mdevhurt1/enpm701-block-retrieval-robot/BOM.xlsx

ENPM809T: Autonomous Robotics
Vendor | Item | Qty | Description / Notes
Adafruit | Raspberry Pi 3 - Model B+ or Model 4 | 1
 | Raspberry Pi Camera Board v2 - 8 Megapixels | 1
 | 16GB Card with NOOBS 3.1 for Raspberry Pi Computers including 4 | 1
 | Half-sized breadboard | 2
 | Ultrasonic distance sensor | 1
 | 5V 2.5A Switching Power Supply with 20AWG MicroUSB Cable | 1
 | 9-DOF Absolute Orientation IMU Fusion Breakout - BNO055 | 1
 | Micro B USB to USB C Adapter | 1
 | USB cable - USB A to Micro-B 3 foot long | 1
RobotShop | 4WD Arduino compatible robot platform w/ encoders | 1
Amazon | Omars Battery Pack Power Bank 10000mAh USB C Battery Bank | 1
 | Pack of 12 inch 40 pin male to female dupont wire, etc. | 1
 | L298N motor drive controller board module, dual H-bridge | 1
 | Rechargable battery charger | 1
 | Rechargable batteries | 1
 | Sterilite 17631706 27 Quart/26 Liter ClearView Latch Box, Clear with Sweet Plum Latches, 6-Pack | 1
 | Hitec 31311S HS-311 Servo Standard Universal | 1
 | Arduino Nano | 1
 | GANA Micro HDMI to HDMI Adapter Cable, Micro HDMI to HDMI Cable (Male to Female) (*Only need 1 per kit) | 0.5
 | Antrader 1-Feet Mini USB 2.0 Cable A-Male to Mini-B 30cm Length 12pcs/lot (*Only need 1 per kit) | 0.08
 | Hilitchi 120pcs M2 Male Female Nylon Hex Spacer | 1
 | Steel machine screw hex nut, #4-40 (*Only need 4 per kit) | 0.04
 | #4-40 x 1/2" stainless pan head phillips machine screw (*Only need 4 per kit) | 0.04
 | Standoff, male to female, 3/16" OD hex, 4-40 x 1" L (*Only need 2 per kit) | 0.2
 | 1000 Ohm resistors | 5
Servo City | Parallel Gripper Kit A | 1
