mdevhurt1/enpm701-block-retrieval-robot/CAD/HBridgeMount.stl

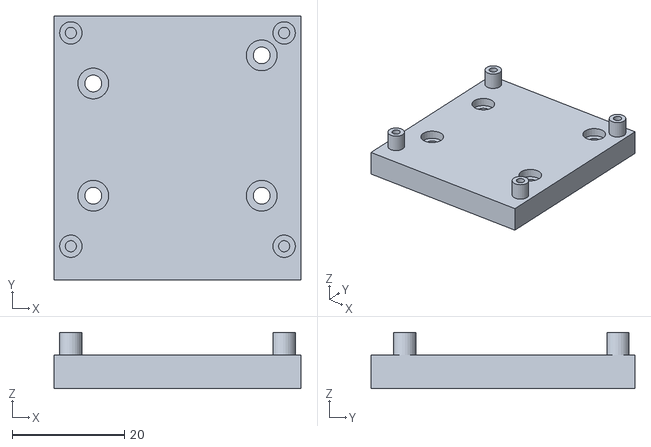
[picture p3: CAD file, 2026-04-25]
CAD/HBridgeMount.stl
44.0 x 47.0 x 10.0
