mdevhurt1/enpm701-block-retrieval-robot/CAD/FlapHolder.stl

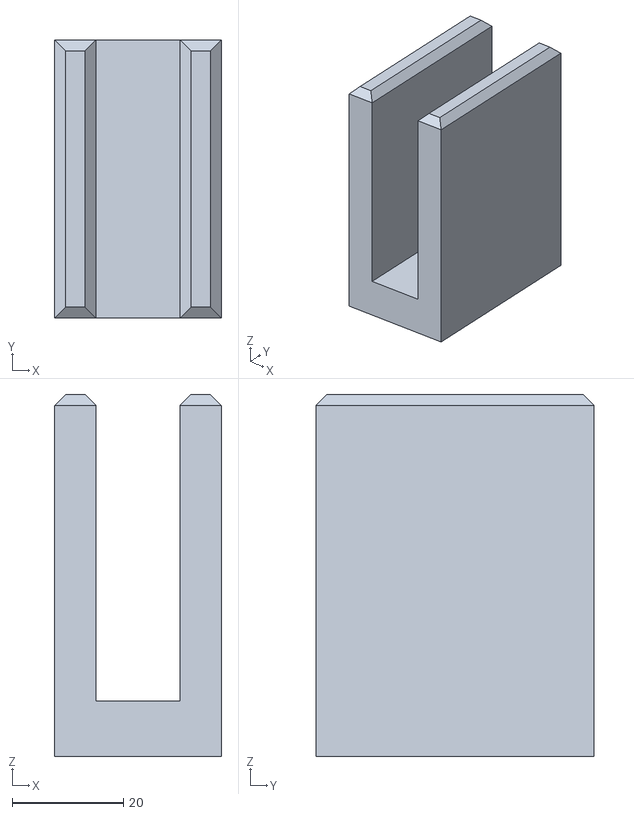
[picture p4: CAD file, 2026-04-25]
CAD/FlapHolder.stl
30.0 x 50.0 x 65.0
