mdevhurt1/enpm701-block-retrieval-robot/ENPM701-Baron-01.step

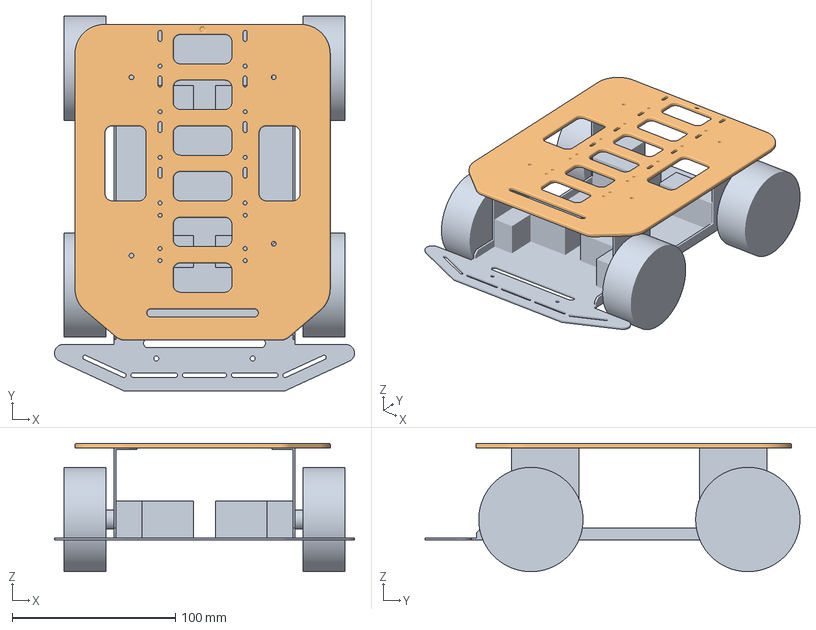
[picture p5: CAD file, 2026-04-25]
ENPM701-Baron-01.step
184.1 x 230.0 x 78.7 mm
ENPM701-Baron-01
ENPM701-Baron-02
