mdevhurt1/enpm701-block-retrieval-robot/CAD/BatteryCage.stl

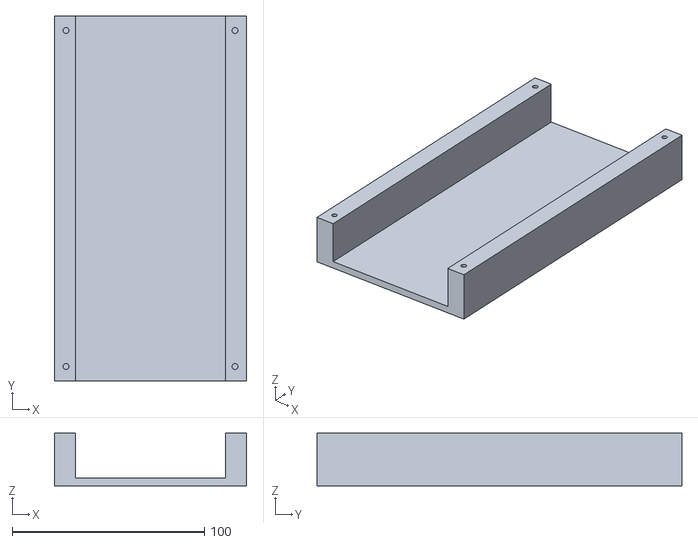
[picture p6: CAD file, 2026-04-25]
CAD/BatteryCage.stl
100.0 x 190.0 x 27.5
