mdevhurt1/enpm701-block-retrieval-robot/CAD/GripperMount.stl

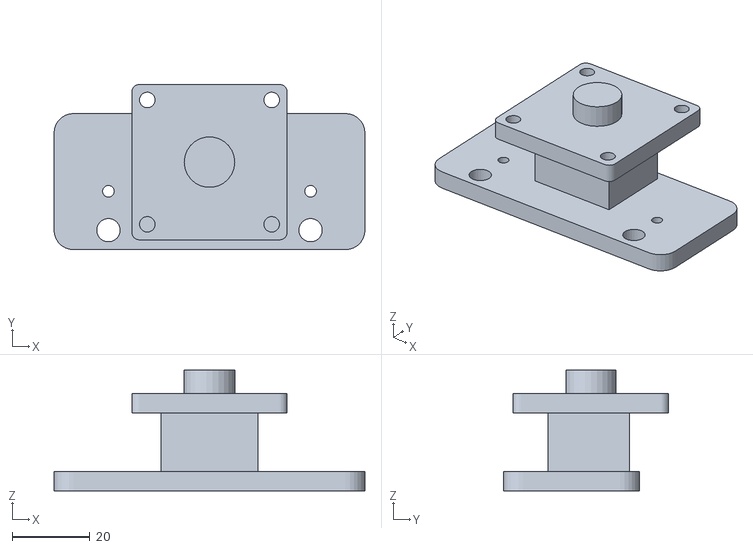
[picture p7: CAD file, 2026-04-25]
CAD/GripperMount.stl
80.0 x 42.5 x 31.0
