mdevhurt1/enpm701-block-retrieval-robot/CAD/ArenaConnector.stl

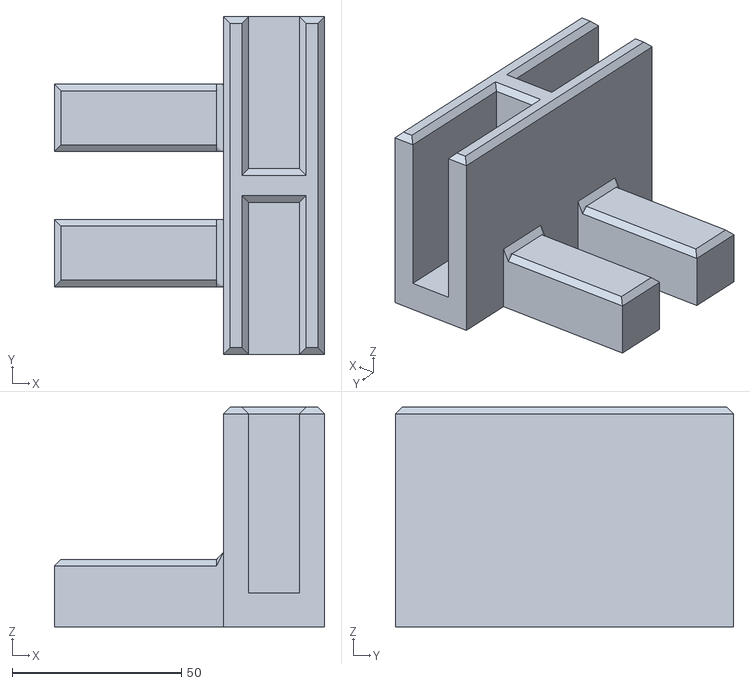
[picture p8: CAD file, 2026-04-25]
CAD/ArenaConnector.stl
80.0 x 100.0 x 65.0
