mdevhurt1/enpm701-block-retrieval-robot/CAD/UltrasonicSensorMount.stl

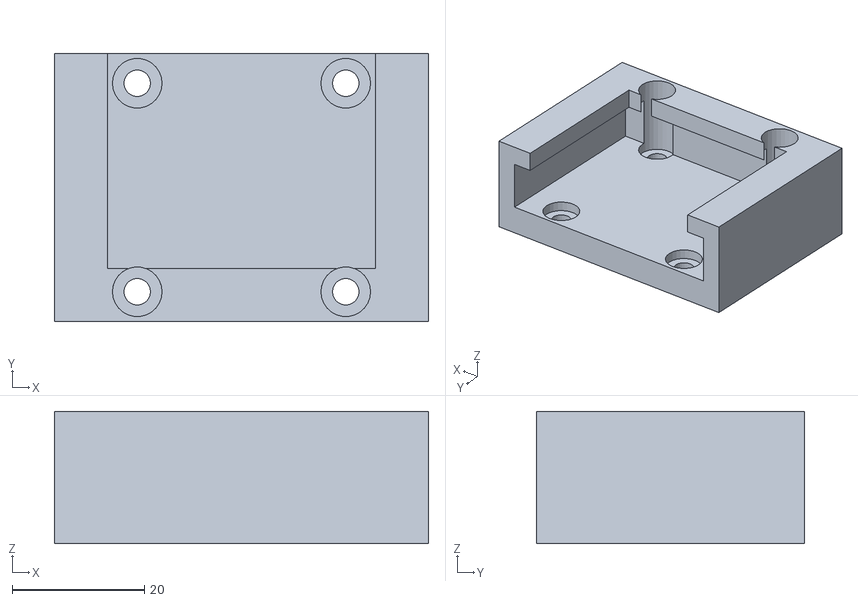
[picture p9: CAD file, 2026-04-25]
CAD/UltrasonicSensorMount.stl
56.5 x 40.5 x 20.0
