mdevhurt1/enpm701-block-retrieval-robot/CAD/CameraMount.stl

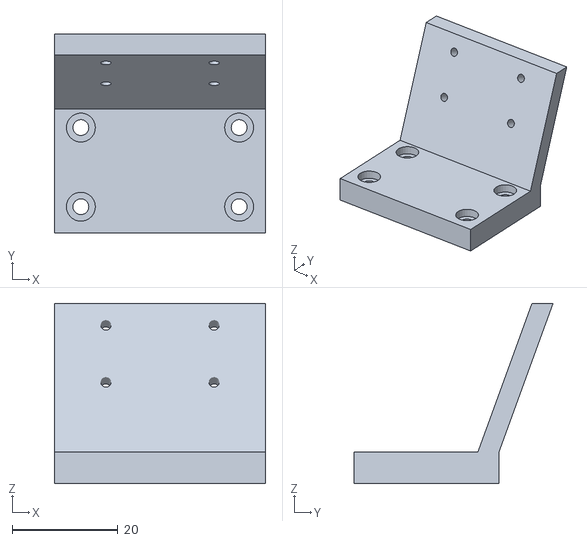
[picture p10: CAD file, 2026-04-25]
CAD/CameraMount.stl
40.0 x 37.8 x 34.2
