mdevhurt1/enpm701-block-retrieval-robot/CAD/RaspberryPi4bMount.stl

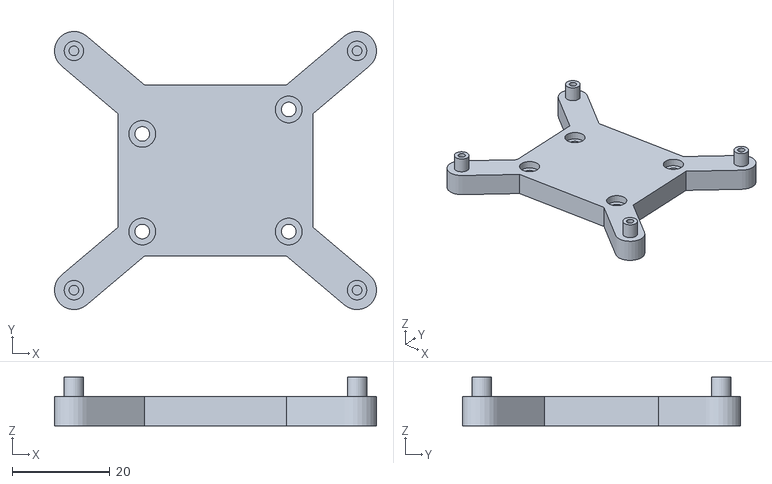
[picture p11: CAD file, 2026-04-25]
CAD/RaspberryPi4bMount.stl
66.0 x 57.0 x 10.0
