mdevhurt1/enpm701-block-retrieval-robot/CAD/Arena90Degree.stl

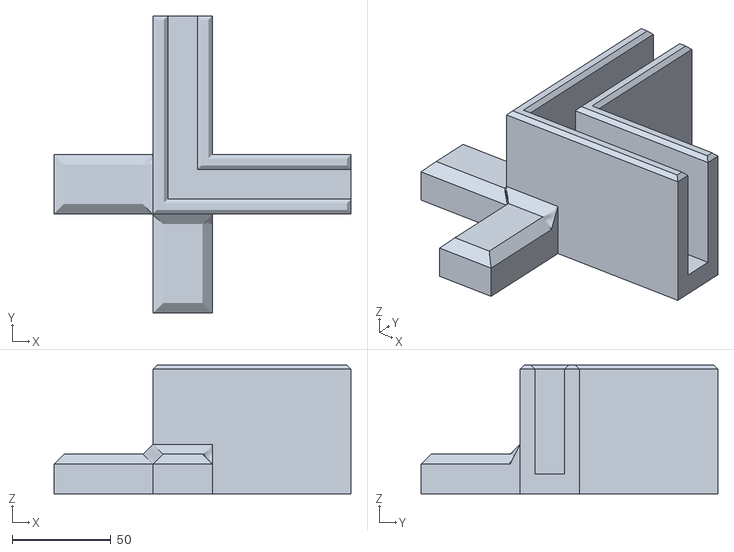
[picture p12: CAD file, 2026-04-25]
CAD/Arena90Degree.stl
150.0 x 150.0 x 65.0
