mdevhurt1/enpm701-block-retrieval-robot/CAD/LargeBreadboardMount.stl

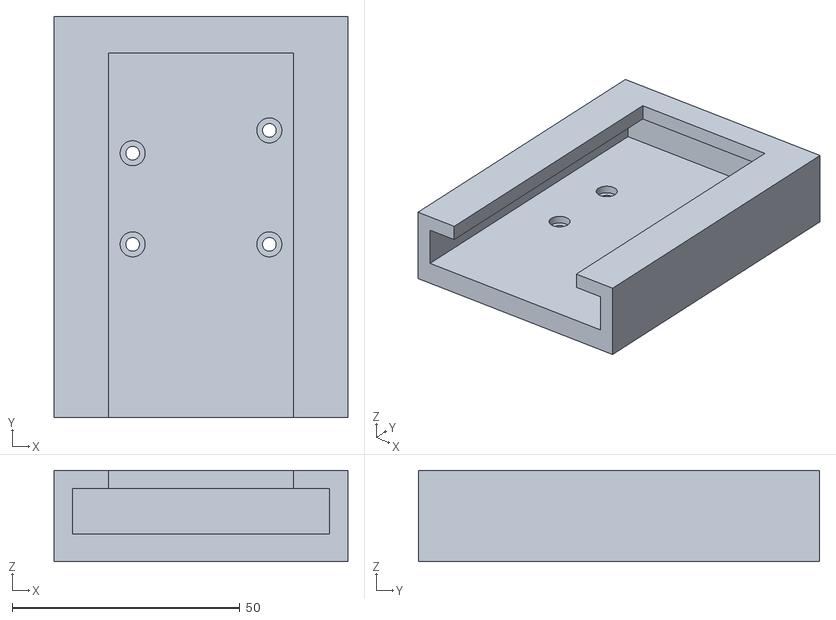
[picture p13: CAD file, 2026-04-25]
CAD/LargeBreadboardMount.stl
64.5 x 88.0 x 20.0
