mdevhurt1/enpm701-block-retrieval-robot/CAD/Robot.FCStd

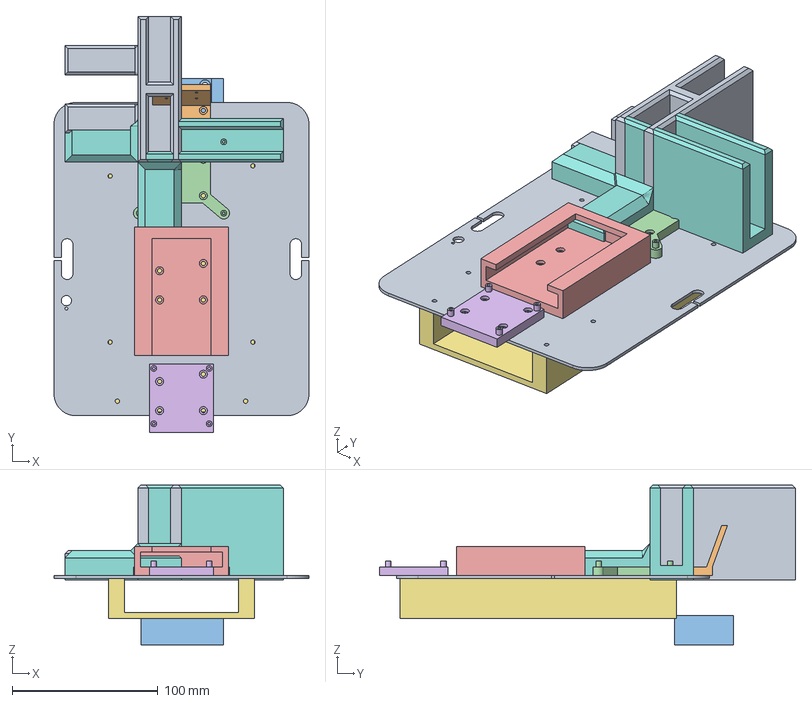
[picture p14: CAD file, 2026-04-25]
CAD/Robot.FCStd
175.0 x 285.5 x 109.6 mm
TopPlate
Camera
UltrasonicSensorMount
RaspberryPi4bMount
LargeBreadboardMount
HBridgeMount
BatteryCage
90Degree
Connector
FlapHolder
