mdevhurt1/enpm701-block-retrieval-robot/CAD/TopPlate.stl

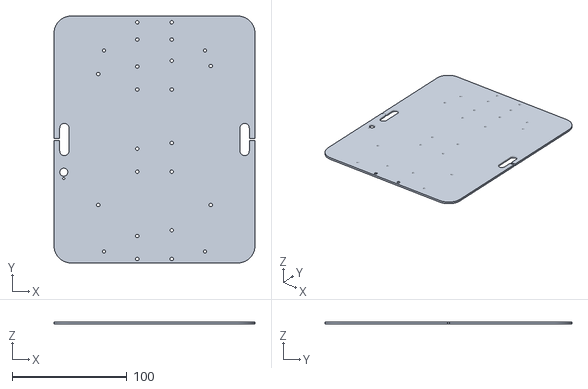
[picture p15: CAD file, 2026-04-25]
CAD/TopPlate.stl
175.0 x 215.0 x 2.00
