mdevhurt1/enpm701-block-retrieval-robot/(list of files, cad)

Other CAD files:
baron_top_plate.FCStd
