mdevhurt1/enpm701-block-retrieval-robot/Electrical/final_project/final_project.kicad_pcb

## KiCad design Electrical/final_project/final_project.kicad_pcb (2026-04-25)

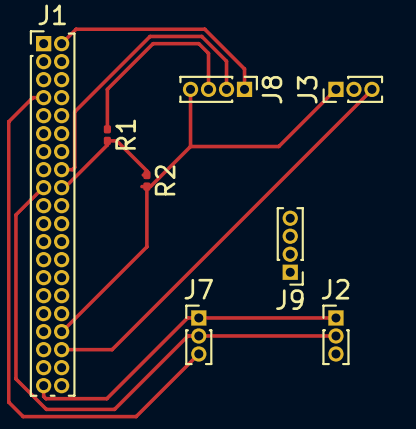
[picture p16: board final_project.kicad_pcb from above]

Board: 2 copper layers, 8 parts (0 on the bottom side), 13 nets.

Parts:
J1: Raspberry_Pi_4b; PinHeader_2x20_P1.00mm_Vertical
J2: Back_Right_Encoder; PinHeader_1x03_P1.00mm_Vertical
J3: Servo; PinHeader_1x03_P1.00mm_Vertical
J7: Front_Left_Encoder; PinHeader_1x03_P1.00mm_Vertical
J8: Ultrasonic; PinHeader_1x04_P1.00mm_Vertical
J9: H-Bridge; PinHeader_1x04_P1.00mm_Vertical
R1: 1k; R_0201_0603Metric
R2: 2k; R_0201_0603Metric

Connections:
/3.3V: J1.1, J1.17, J2.2, J7.2
/5v: J1.2, J8.1
/BRENC: J1.12, J2.3
/ECHO: J1.18, R1.2, R2.1
/FLENC: J1.7, J7.3
/GND: J1.6, J1.9, J1.14, J1.34, J1.39, J2.1, J3.1, J7.1, J8.4, R2.2
/IN1: J1.31, J9.4
/IN2: J1.33, J9.3
/IN3: J1.35, J9.2
/IN4: J1.37, J9.1
/Servo: J1.36, J3.3
/TRIG: J1.16, J8.2
unnamed: J8.3, R1.1
