mdevhurt1/enpm701-block-retrieval-robot/fp/state_machine.py

"""
state_machine.py - Backward-compatibility shim.

All FSM logic lives in fp/fsm/.  This module re-exports everything so that
existing callers (cli.py, teleop.py, tests) require no changes.
"""

import time  # exposed as state_machine.time for test patching

from fp import navigation  # exposed as state_machine.navigation for test patching
from fp import vision       # exposed as state_machine.vision for test patching

from fp.fsm.context import (
    RobotContext,
    FSMTestHooks,
    Pose,
    Scoring,
    Search,
    Cooldowns,
    set_collection_zone,
)
from fp.fsm.states import (
    State,
    COLOR_ORDER,
    TOTAL_BLOCKS,
    SEARCH_HEADINGS_DEG,
    MAX_SEARCH_SWEEPS,
    WALL_HEADING,
    P0_DIAG,
    _pose,
    _fmt_xy,
    _fmt_cov_diag,
    _pose_delta,
    _sync,
    _nearest_wall,
    _obstacle_detected,
    _correction_due,
    _deliver_drive_to_zone,
    _deliver_align_at_zone,
    _deliver_bookkeeping,
    _deliver_async_image,
    _deliver_safe_backup,
    _handle_init,
    _handle_discover,
    _handle_approach,
    _handle_grab,
    _handle_deliver,
    _handle_avoid,
    _handle_update,
    _handle_complete,
    InitState,
    DiscoverState,
    ApproachState,
    GrabState,
    DeliverState,
    AvoidState,
    UpdateState,
    CompleteState,
    _STATE_CLASSES,
)
from fp.fsm.runner import run, Runner, FsmControl

__all__ = [
    "time",
    "navigation",
    "vision",
    "RobotContext",
    "FSMTestHooks",
    "Pose",
    "Scoring",
    "Search",
    "Cooldowns",
    "set_collection_zone",
    "State",
    "COLOR_ORDER",
    "TOTAL_BLOCKS",
    "SEARCH_HEADINGS_DEG",
    "MAX_SEARCH_SWEEPS",
    "WALL_HEADING",
    "P0_DIAG",
    "_pose",
    "_fmt_xy",
    "_fmt_cov_diag",
    "_pose_delta",
    "_sync",
    "_nearest_wall",
    "_obstacle_detected",
    "_correction_due",
    "_deliver_drive_to_zone",
    "_deliver_align_at_zone",
    "_deliver_bookkeeping",
    "_deliver_async_image",
    "_deliver_safe_backup",
    "_handle_init",
    "_handle_discover",
    "_handle_approach",
    "_handle_grab",
    "_handle_deliver",
    "_handle_avoid",
    "_handle_update",
    "_handle_complete",
    "InitState",
    "DiscoverState",
    "ApproachState",
    "GrabState",
    "DeliverState",
    "AvoidState",
    "UpdateState",
    "CompleteState",
    "_STATE_CLASSES",
    "run",
    "Runner",
    "FsmControl",
]
