mdevhurt1/enpm701-block-retrieval-robot/fp/vision.py

# Final Project - Camera Capture and HSV Block Detection
# Picamera2 video capture with background frame caching and per-second
# timelapse recording. HSV masks detect red, green, and blue blocks via
# contour filtering; thresholds were tuned under arena lighting.
#
# Requirements: picamera2, libcamera, opencv-python, numpy
import logging
import os
import threading
import time
from dataclasses import dataclass
from typing import Dict
import cv2
import numpy as np

from picamera2 import Picamera2
from libcamera import controls

logger = logging.getLogger(__name__)

# Frame and FOV
SENSOR_RESOLUTION   = (1280, 720)
CAMERA_HFOV_DEG     = 41.2

# HSV ranges per color, OR'd. Two ranges for red (hue wraps).
COLOR_MASKS = {
    "red": [
                (165, 100, 80, 179, 235, 255),
                (0, 100, 80, 5, 235, 255)
    ],
    "blue": [
                (95, 120, 100, 120, 255, 255)
    ],
    "green": [
                (42, 110, 80, 82, 255, 255)
    ],
}

# Detection thresholds
MIN_BLOB_AREA       = {"red": 10_000,   "green": 10_000,     "blue": 10_000,    }
IN_REACH_TOLERANCE  = {"red": 150_000,  "green": 120_000,    "blue": 120_000,    }
TOO_CLOSE_TOLERANCE = {"red": 70_000,   "green": 70_000,     "blue": 70_000,    }
# Reject blob centroids whose y-coordinate is below this row in the rotated
# frame (image is 720 px tall after the 90 deg rotation, so this is just
# above the lower 45 percent). Real block detections in the field show
# cy in the 120-280 range; floor-glare phantoms (specular highlights on
# the polished arena hitting the blue HSV mask) show cy in the 590-680
# range. The threshold is between those clusters with margin to spare.
VISION_MAX_VALID_CY = 600

_TIMELAPSE_DIR = "time_lapse"
_last_timelapse_t: float = 0.0

# Camera intrinsic calibration
_CAL_PATH = os.path.join(
    os.path.dirname(os.path.dirname(os.path.abspath(__file__))),
    "calibration", "camera_matrix.npz",
)
_camera_matrix: np.ndarray  = None
_dist_coeffs: np.ndarray    = None
_calibrated: bool           = False

try:
    _cal = np.load(_CAL_PATH)
    _camera_matrix = _cal["camera_matrix"]
    _dist_coeffs = _cal["dist_coeffs"]
    _calibrated = True
    logger.info(f"[CAM] Loaded camera calibration from {_CAL_PATH}")
except FileNotFoundError:
    logger.info(f"[CAM] Calibration file not found: {_CAL_PATH}")
except (KeyError, Exception) as _cal_err:
    logger.info(f"[CAM] Failed to load camera calibration: {_cal_err!r}")

def is_calibrated() -> bool:
    return _calibrated

def get_camera_matrix() -> np.ndarray:
    return _camera_matrix

@dataclass
class DetectionResult:
    label: str
    cx: int
    cy: int
    area: float

    @property
    def within_reach(self) -> bool:
        return self.area >= IN_REACH_TOLERANCE.get(self.label, float('inf'))

    @property
    def block_too_close(self) -> bool:
        return self.area >= TOO_CLOSE_TOLERANCE.get(self.label, float('inf'))

    @property
    def centroid_error(self) -> int:
        return self.cx - SENSOR_RESOLUTION[0] // 2 + SENSOR_RESOLUTION[0] // 50

_picam2 = None
def init_camera() -> Picamera2:
    global _picam2
    _picam2 = Picamera2()

    # camera is mounted rotated 90 degrees
    cfg = _picam2.create_video_configuration(main={"size": (SENSOR_RESOLUTION[1], SENSOR_RESOLUTION[0]), "format": "RGB888"})
    _picam2.configure(cfg)
    _picam2.start()
    _picam2.set_controls({"AwbMode": controls.AwbModeEnum.Auto})

    time.sleep(3)  # AE/AWB settle
    _start_cache_warmer()
    return _picam2


def release_camera() -> None:
    global _picam2
    _stop_cache_warmer()
    if _picam2 is not None:
        _picam2.stop()

_FRAME_REUSE_TIME = 0.03
_last_frame = None
_last_frame_time = 0.0
# Held during the picamera2 capture call so the cache warmer thread and the
# foreground (FSM/motion) calls don't race on capture_array() or the cache
# globals. Holding through the capture also coalesces simultaneous callers
# onto a single frame.
_capture_lock = threading.Lock()
def capture_frame() -> np.ndarray:
    global _last_timelapse_t
    global _last_frame
    global _last_frame_time

    with _capture_lock:
        now = time.monotonic()
        if (now - _last_frame_time) < _FRAME_REUSE_TIME:
            return _last_frame

        _last_frame_time = now

        _last_frame = _picam2.capture_array()
        _last_frame = cv2.rotate(_last_frame, cv2.ROTATE_90_COUNTERCLOCKWISE)

        if now - _last_timelapse_t > 1.0:
            _last_timelapse_t = now
            os.makedirs(_TIMELAPSE_DIR, exist_ok=True)
            fname = os.path.join(_TIMELAPSE_DIR, f"{now:.3f}.jpg")
            cv2.imwrite(fname, _last_frame)

        return _last_frame


# Background cache warmer. Once-per-second tick keeps the picamera2 buffer
# drained and the timelapse rolling without any FSM-driven action; foreground
# callers within FRAME_REUSE_TIME of a tick get the cached frame for free.
_WARMER_INTERVAL_S = 1.0
_warmer_thread: threading.Thread = None
_warmer_stop = threading.Event()


def _cache_warmer_loop() -> None:
    while not _warmer_stop.wait(_WARMER_INTERVAL_S):
        try:
            capture_frame()
        except Exception as e:
            logger.warning(f"[VISION] cache warmer iteration failed: {e!r}")


def _start_cache_warmer() -> None:
    global _warmer_thread
    if _warmer_thread is not None and _warmer_thread.is_alive():
        return
    _warmer_stop.clear()
    _warmer_thread = threading.Thread(
        target=_cache_warmer_loop,
        daemon=True,
        name="vision-cache-warmer",
    )
    _warmer_thread.start()
    logger.info(f"[VISION] cache warmer started ({_WARMER_INTERVAL_S:.1f}s interval)")


def _stop_cache_warmer() -> None:
    global _warmer_thread
    if _warmer_thread is None:
        return
    _warmer_stop.set()
    _warmer_thread.join(timeout=2.0)
    _warmer_thread = None
    logger.info("[VISION] cache warmer stopped")


def _build_mask(hsv: np.ndarray, ranges) -> np.ndarray:
    combined = np.zeros(hsv.shape[:2], dtype=np.uint8)
    for (h_lo, s_lo, v_lo, h_hi, s_hi, v_hi) in ranges:
        lo = np.array([h_lo, s_lo, v_lo], dtype=np.uint8)
        hi = np.array([h_hi, s_hi, v_hi], dtype=np.uint8)
        combined = cv2.bitwise_or(combined, cv2.inRange(hsv, lo, hi))

    return combined


def _best_contour(mask: np.ndarray, label: str) -> tuple[np.ndarray, float, int, int]:
    kernel = cv2.getStructuringElement(cv2.MORPH_ELLIPSE, (5, 5))
    mask = cv2.morphologyEx(mask, cv2.MORPH_OPEN, kernel)
    mask = cv2.morphologyEx(mask, cv2.MORPH_CLOSE, kernel)

    contours, _ = cv2.findContours(mask, cv2.RETR_EXTERNAL, cv2.CHAIN_APPROX_SIMPLE)

    if not contours:
        return None
    
    candidates = []
    for c in contours:
        area = cv2.contourArea(c)
        if area < MIN_BLOB_AREA.get(label, float('inf')):
            continue

        M = cv2.moments(c)
        if M["m00"] == 0:
            continue

        cx = int(M["m10"] / M["m00"])
        cy = int(M["m01"] / M["m00"])
        # Drop candidates whose centroid lies in the lower portion of the
        # rotated frame - those are floor reflections / specular glare on
        # the wood, not real blocks. See VISION_MAX_VALID_CY for the
        # numerical justification.
        if cy > VISION_MAX_VALID_CY:
            continue
        candidates.append((c, area, cx, cy))

    if not candidates:
        return None
    
    return max(candidates, key=lambda t: t[1])


def detect_all_colors() -> Dict[str, DetectionResult]:
    frame = capture_frame()
    if frame is None:
        logger.info("[VISION] detect_all_colors received None frame for detection")
        return {c: None for c in COLOR_MASKS}
    
    hsv = cv2.cvtColor(frame, cv2.COLOR_BGR2HSV)
    out: Dict[str, DetectionResult] = {}
    for label, ranges in COLOR_MASKS.items():
        mask = _build_mask(hsv, ranges)
        result = _best_contour(mask, label)

        if result is None:
            out[label] = None
        else:
            _, area, cx, cy = result
            out[label] = DetectionResult(label=label, cx=cx, cy=cy, area=area)
    return out


def detect_block(target: str) -> DetectionResult:
    if target not in COLOR_MASKS:
        logger.info(f"[VISION] Invalid target color '{target}' for detection")
        return None

    dets = detect_all_colors()
    return dets.get(target)
