mdevhurt1/enpm701-block-retrieval-robot/fp/navigation.py

from fp.localization import (
    Localizer,
    loc as _nav,
    init_ekf,
    set_heading_offset,
    get_arena_heading,
    get_arena_heading_or_none,
    _arena_to_imu,
    start_odometry,
    stop_odometry,
    get_pose,
    set_pose,
    get_path,
    _median_distance,
    _trimmed_mean_distance,
    _batched_trimmed_mean_distance,
    _expected_wall_sensor_distance,
    correct_pose_from_wall,
    _find_wall_perpendicular,
    _sweep_and_fit_perpendicular,
    calibrate_initial_pose,
)

from fp.motion import (
    KP_DIST,
    KD_DIST,
    MAX_CORRECTION,
    KP_HDG_HOLD,
    KP_HDG,
    KD_HDG,
    MIN_TURN_DUTY,
    KP_VISUAL,
    _WALL_ESCAPE_CM,
    _run_distance,
    _run_heading,
    move_forward,
    move_reverse,
    pivot_left,
    pivot_right,
    pivot_to_heading,
    approach_visual,
    navigate_to,
    follow_path,
)

from fp import hal
import time  # retained so existing patches on navigation.time still work
